1412661/smarthome/Code/Web service/pictures/files/manual/3.3.2014/21.32.25.jpg

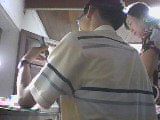
Code/Web service/pictures/files/manual/3.3.2014/21.32.25.jpg
