1412661/smarthome/Code/Web service/pictures/files/manual/4.3.2014/11.13.43.jpg

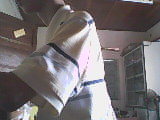
Code/Web service/pictures/files/manual/4.3.2014/11.13.43.jpg
