1412661/smarthome/Code/Web service/function/readme.txt

Thư mục lưu trữ các file php cung cấp các hàm (function) hỗ trợ cho việc vận hành website.
