1412661/smarthome/Code/Web service/class/phpmailer/readme.txt

Thư mục chứa PHP Class hỗ trợ việc gửi mail
