1412661/smarthome/Code/Web service/class/xtemplate/readme.txt

Thư mục chứa template engine của website
