1412661/smarthome/Code/Web service/pictures/files/auto/4.3.2014/13.14.15.jpg

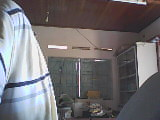
Code/Web service/pictures/files/auto/4.3.2014/13.14.15.jpg
