1412661/smarthome/Code/Web service/pictures/files/auto/7.3.2014/20.8.27.jpg

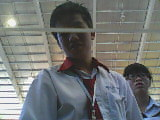
Code/Web service/pictures/files/auto/7.3.2014/20.8.27.jpg
