1412661/smarthome/Code/Web service/pictures/files/auto/7.3.2014/22.23.14.jpg

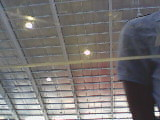
Code/Web service/pictures/files/auto/7.3.2014/22.23.14.jpg
