1412661/smarthome/Code/Web service/template/image/login.jpg

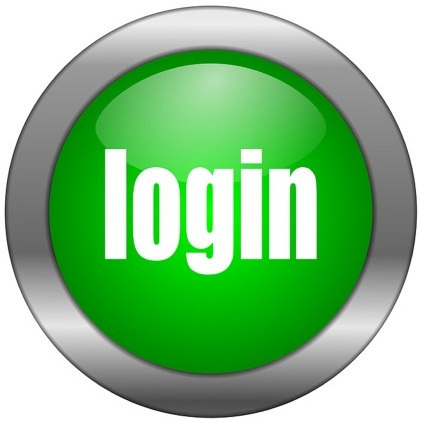
Code/Web service/template/image/login.jpg
