1412661/smarthome/NguyenQuocBao_PhuYen.jpg

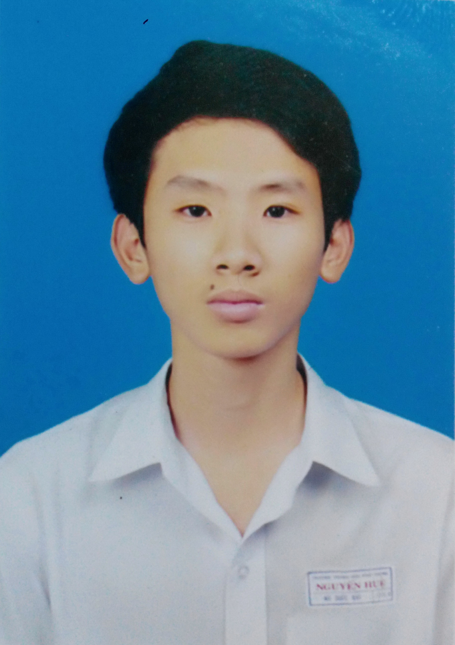
NguyenQuocBao_PhuYen.jpg
