1412661/smarthome/Pic/01012007207.jpg

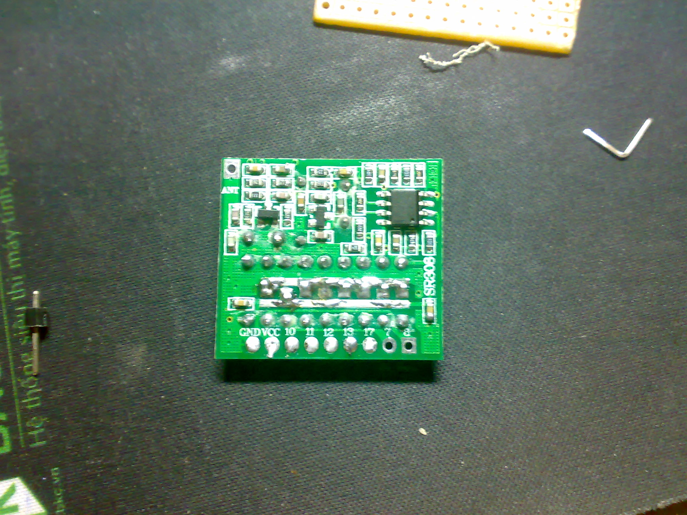
Pic/01012007207.jpg
