1412661/smarthome/Pic/01012007208.jpg

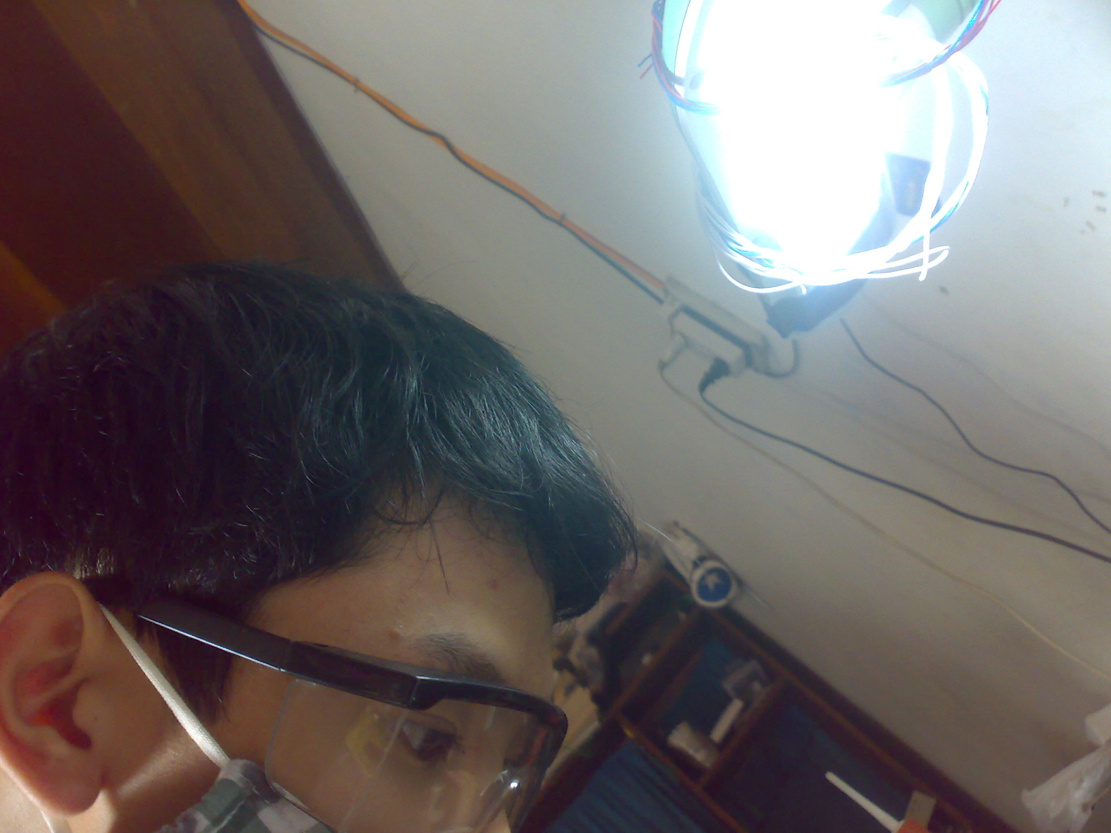
Pic/01012007208.jpg
