1412661/smarthome/Pic/01012007209.jpg

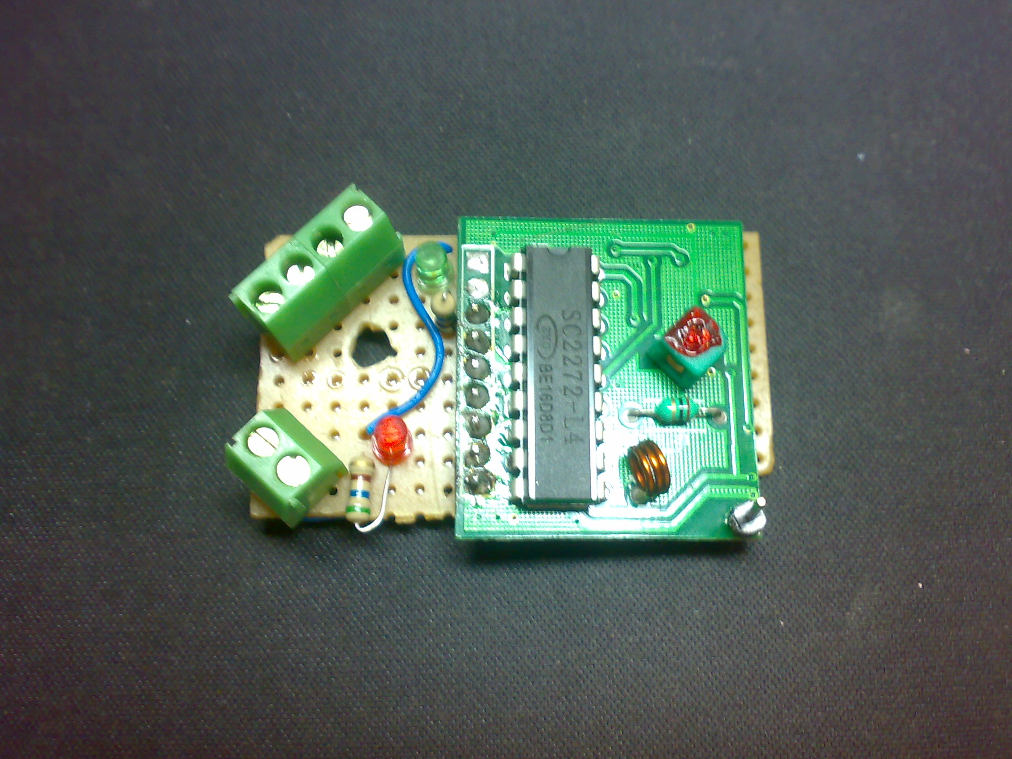
Pic/01012007209.jpg
