1412661/smarthome/Pic/01012007212.jpg

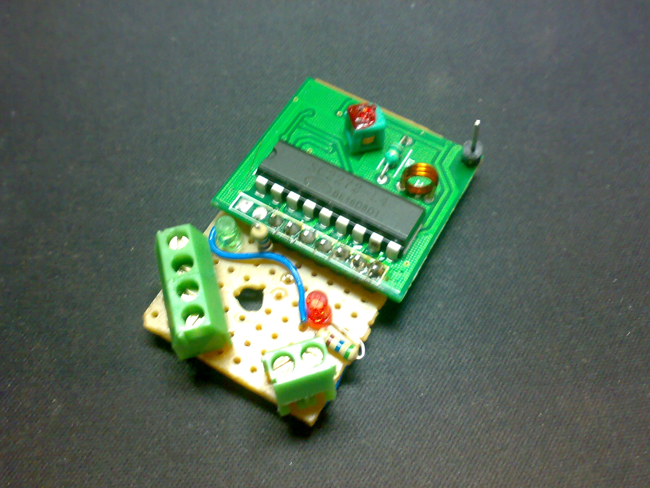
Pic/01012007212.jpg
