1412661/smarthome/Pic/01012007218.jpg

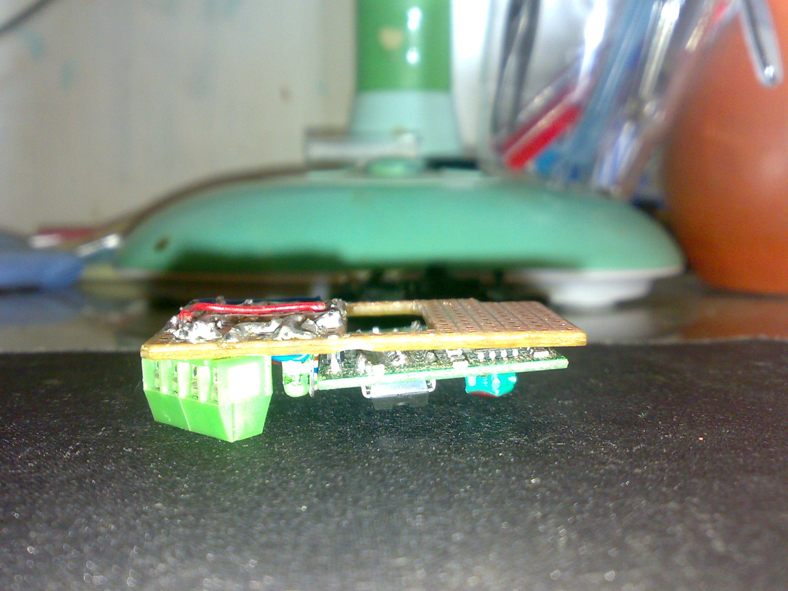
Pic/01012007218.jpg
