1412661/smarthome/Pic/01012014253.jpg

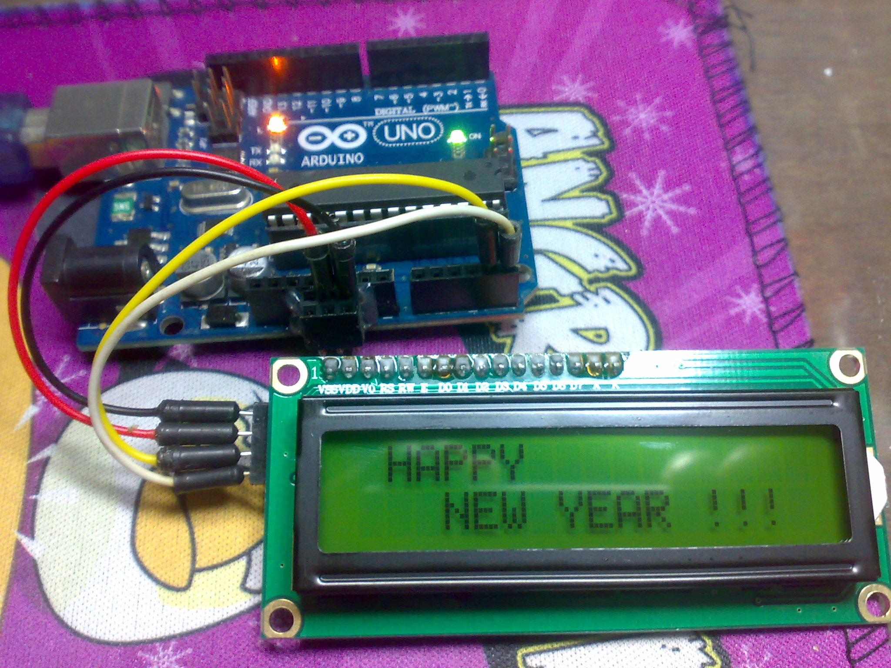
Pic/01012014253.jpg
