1412661/smarthome/Pic/02012014254.jpg

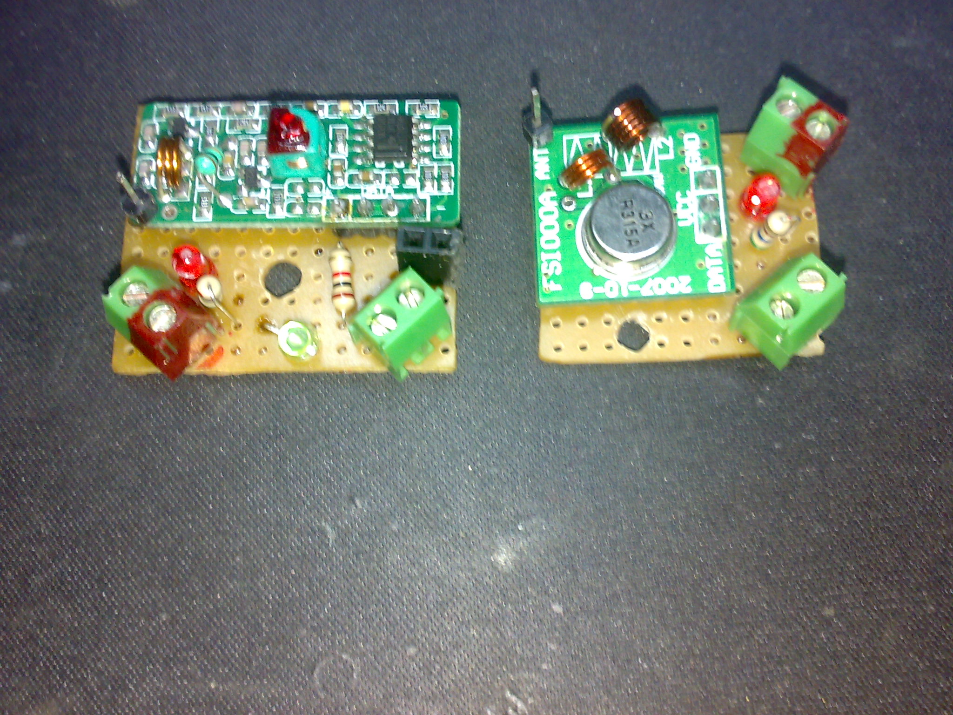
Pic/02012014254.jpg
