1412661/smarthome/Pic/02012014255.jpg

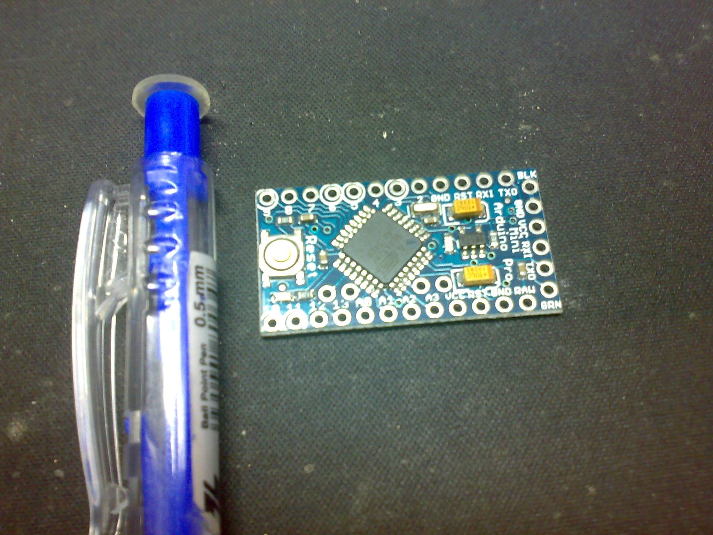
Pic/02012014255.jpg
