1412661/smarthome/Pic/04012014260.jpg

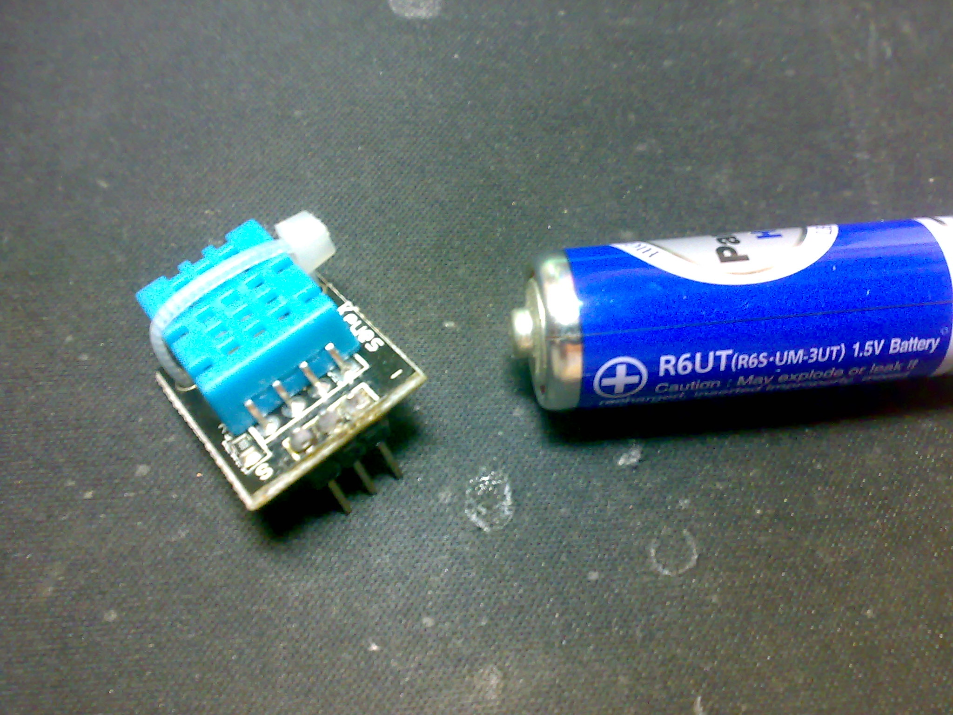
Pic/04012014260.jpg
