1412661/smarthome/Pic/04012014261.jpg

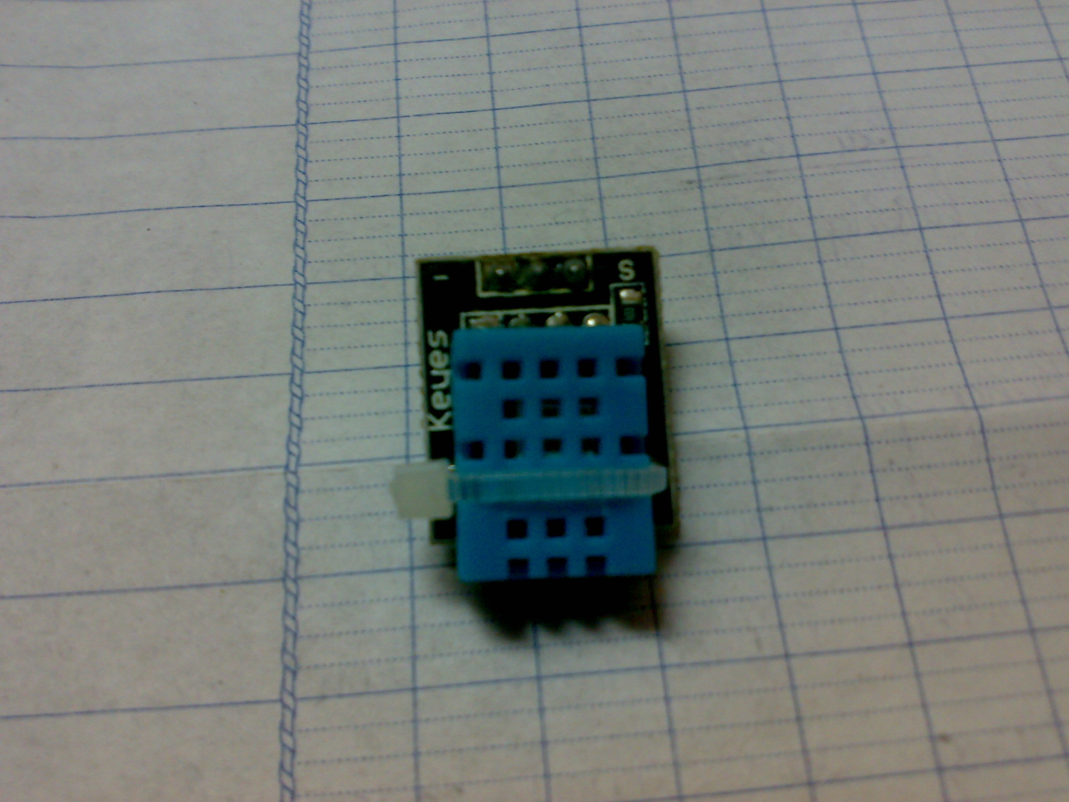
Pic/04012014261.jpg
