1412661/smarthome/Pic/04012014263.jpg

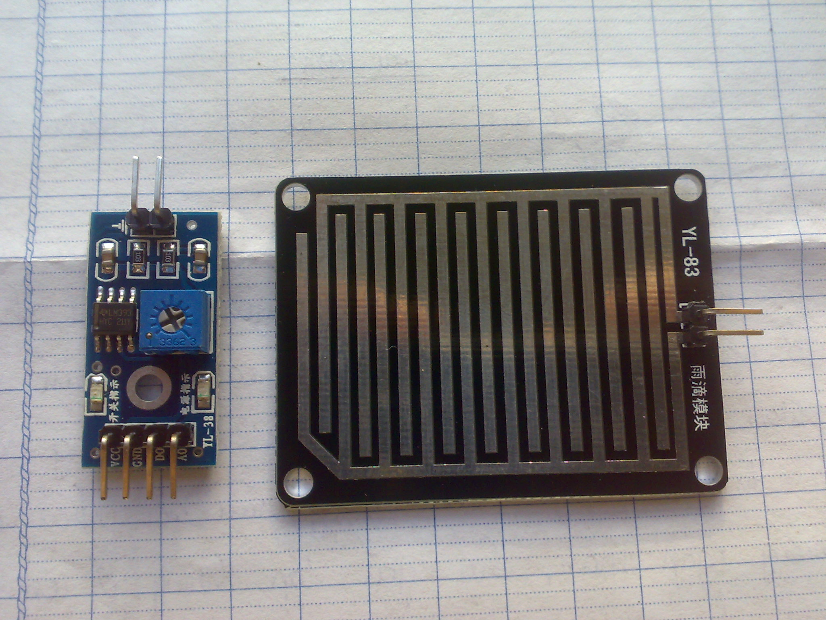
Pic/04012014263.jpg
