1412661/smarthome/Pic/04012014264.jpg

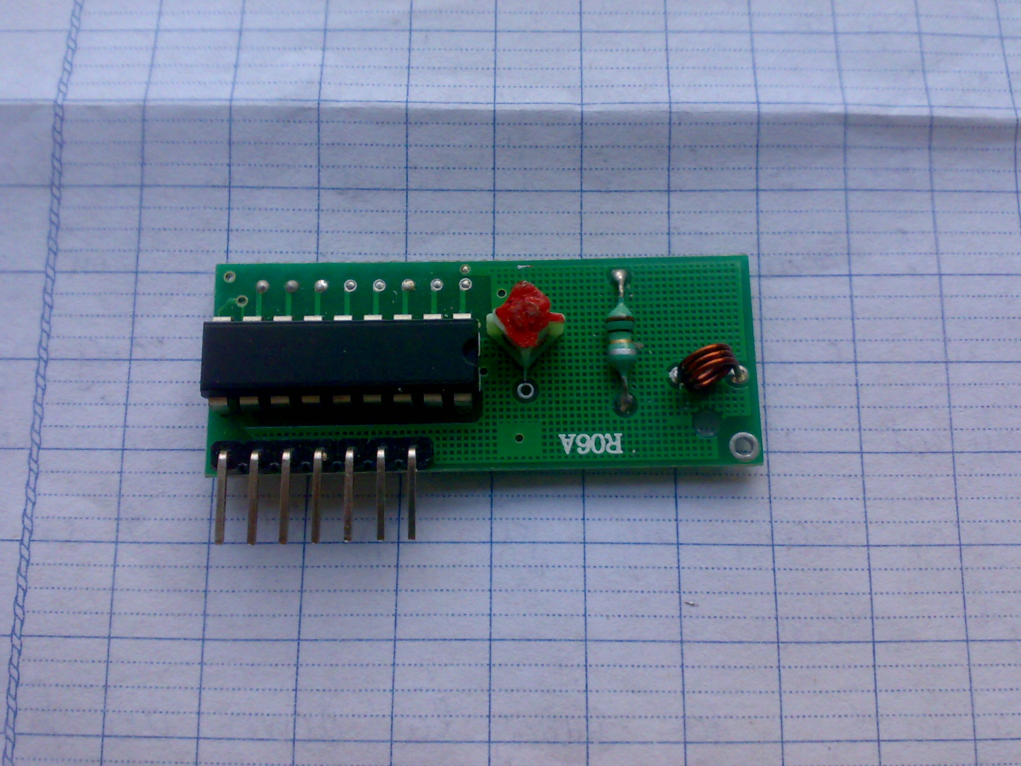
Pic/04012014264.jpg
