1412661/smarthome/Pic/04012014265.jpg

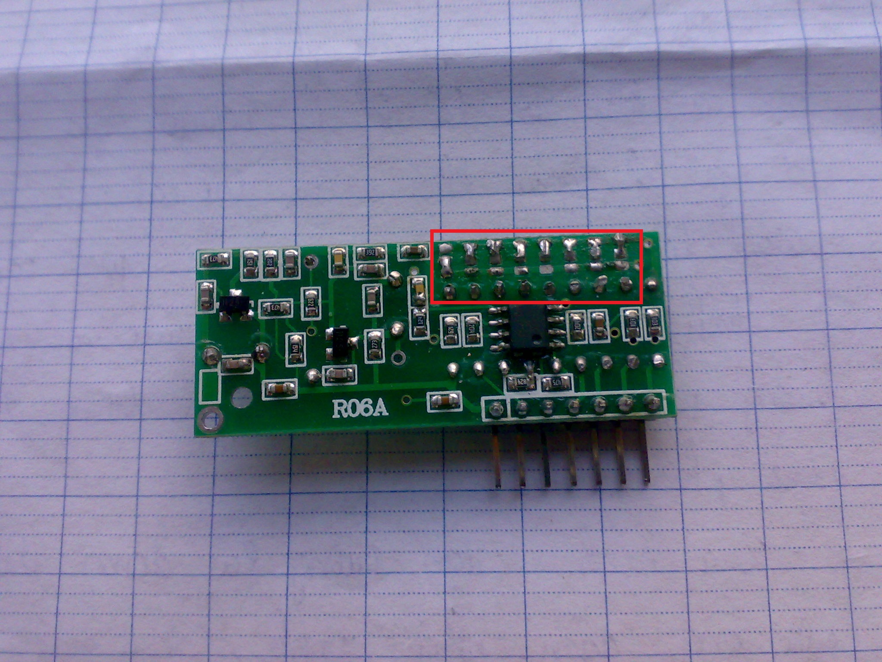
Pic/04012014265.jpg
