1412661/smarthome/Pic/04012014267.jpg

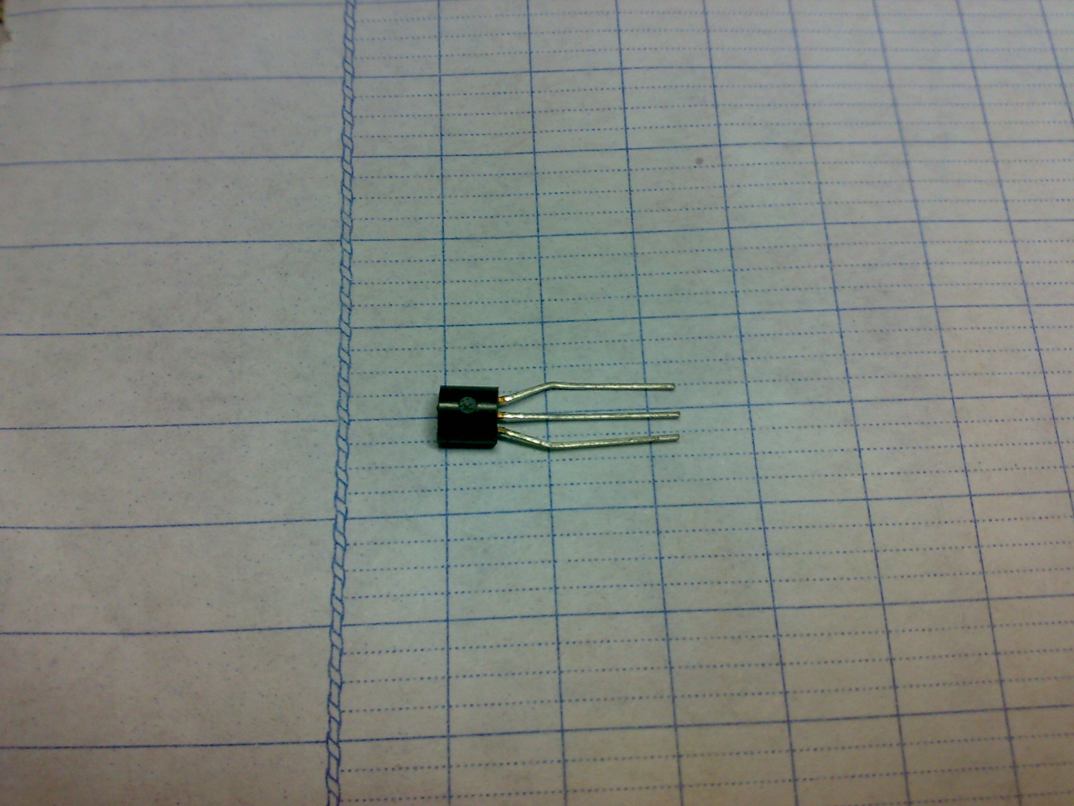
Pic/04012014267.jpg
