1412661/smarthome/Pic/05012014268.jpg

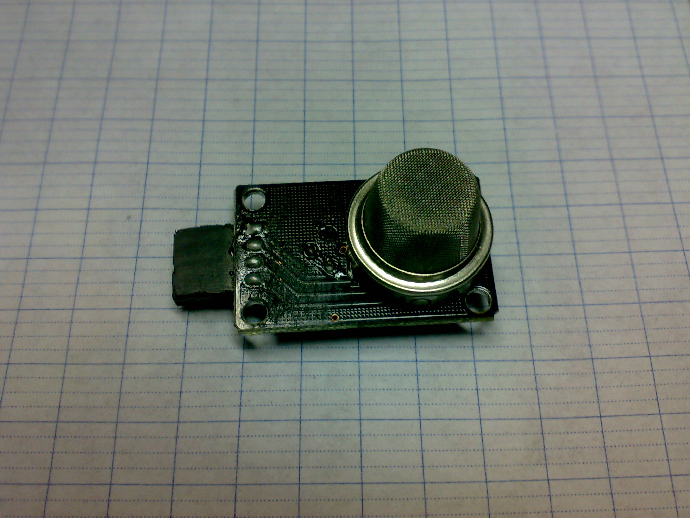
Pic/05012014268.jpg
