1412661/smarthome/Pic/05012014269.jpg

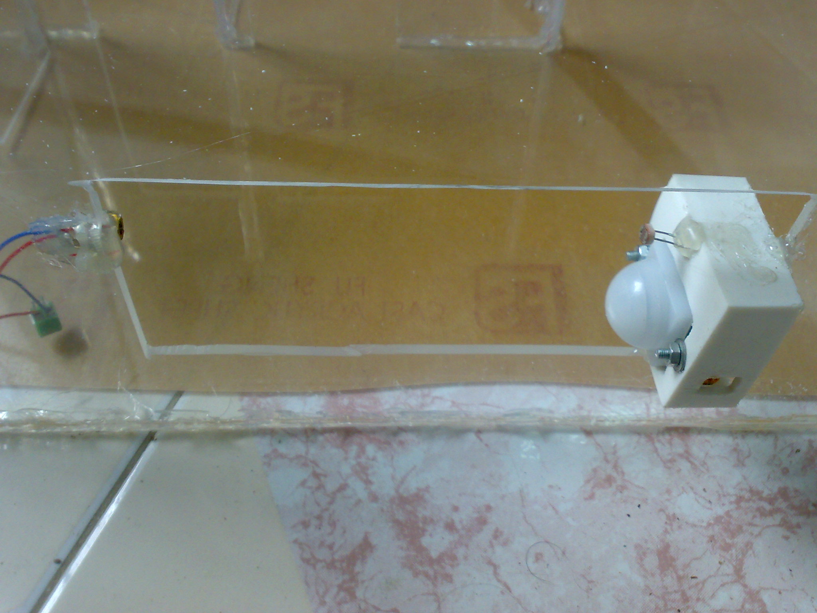
Pic/05012014269.jpg
