1412661/smarthome/Pic/05012014272.jpg

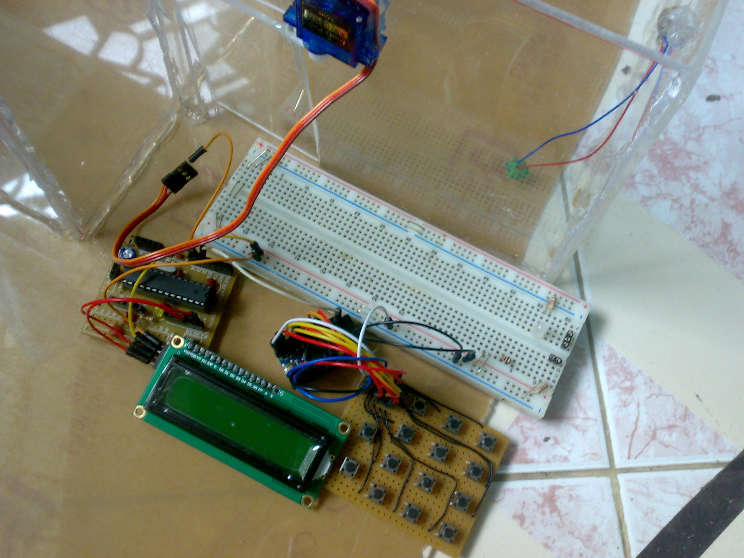
Pic/05012014272.jpg
