1412661/smarthome/Pic/07012014273.jpg

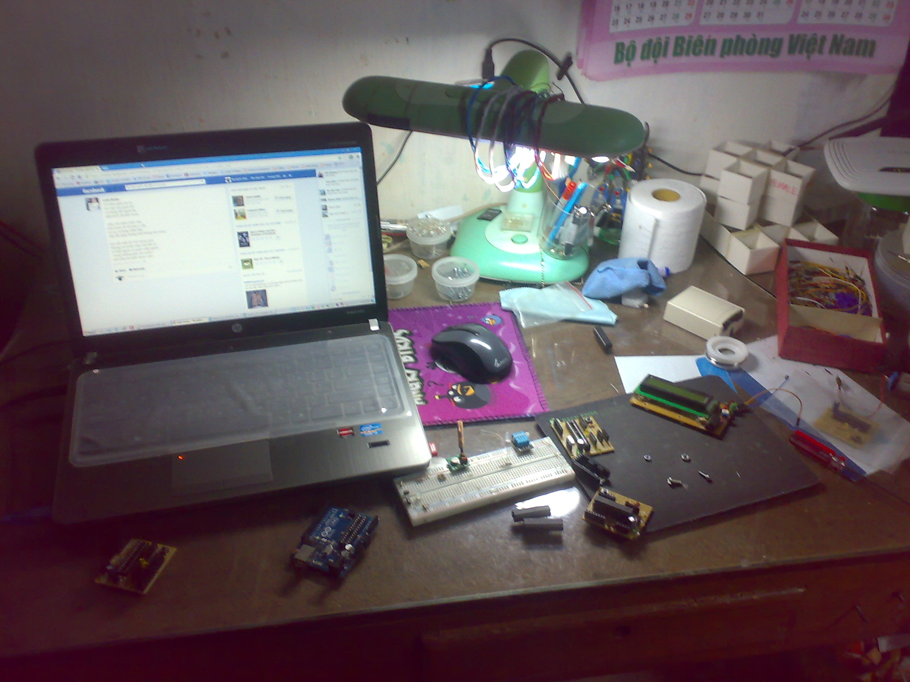
Pic/07012014273.jpg
