1412661/smarthome/Pic/07012014274.jpg

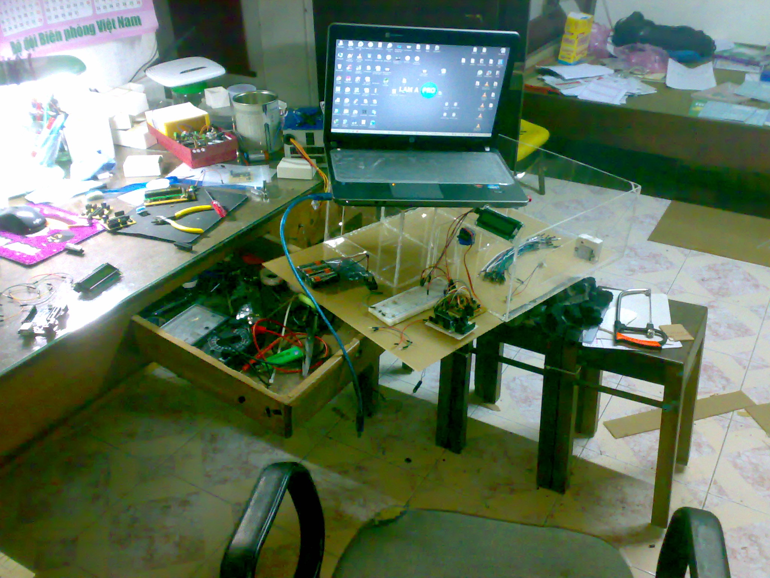
Pic/07012014274.jpg
