1412661/smarthome/Pic/08012014275.jpg

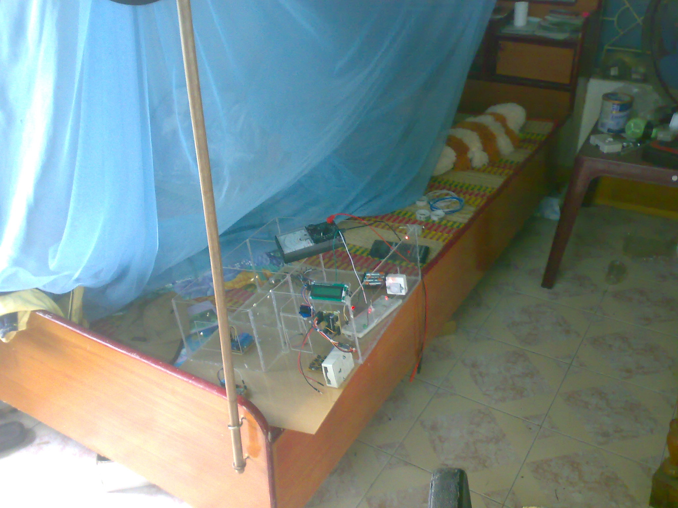
Pic/08012014275.jpg
