1412661/smarthome/Pic/08012014276.jpg

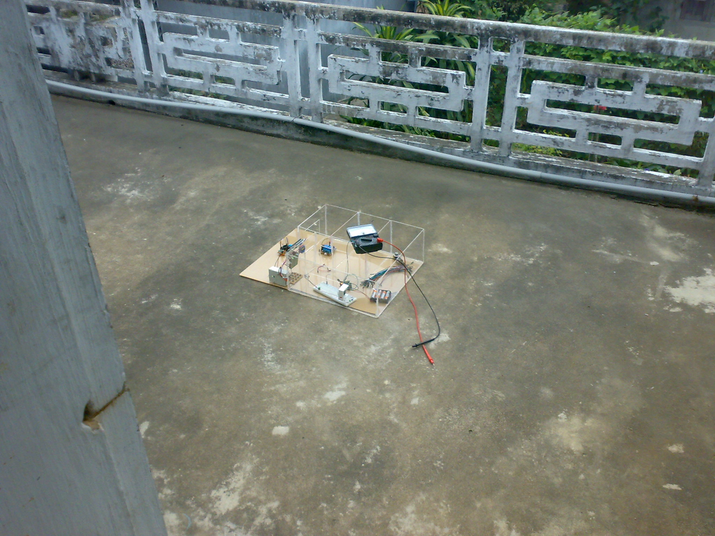
Pic/08012014276.jpg
