1412661/smarthome/Pic/09012014278.jpg

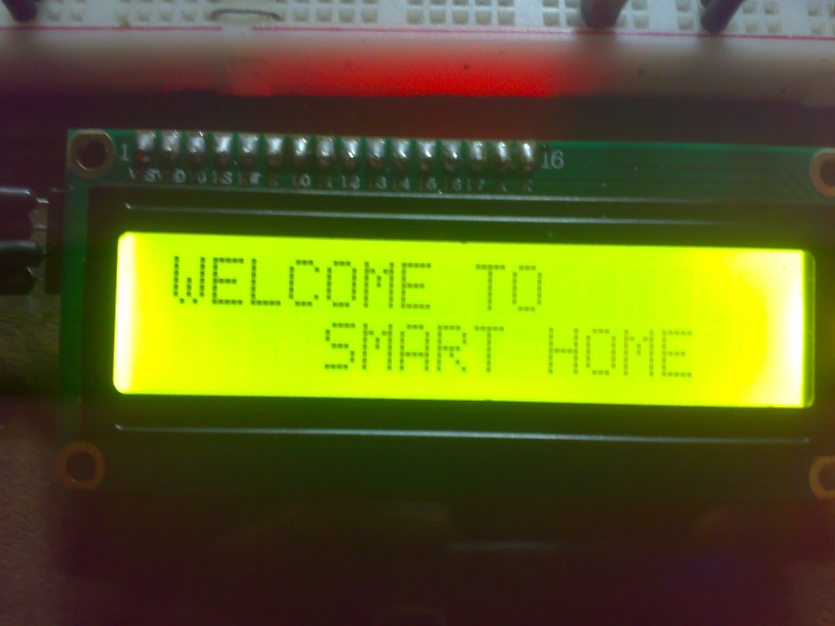
Pic/09012014278.jpg
