1412661/smarthome/Pic/09012014279.jpg

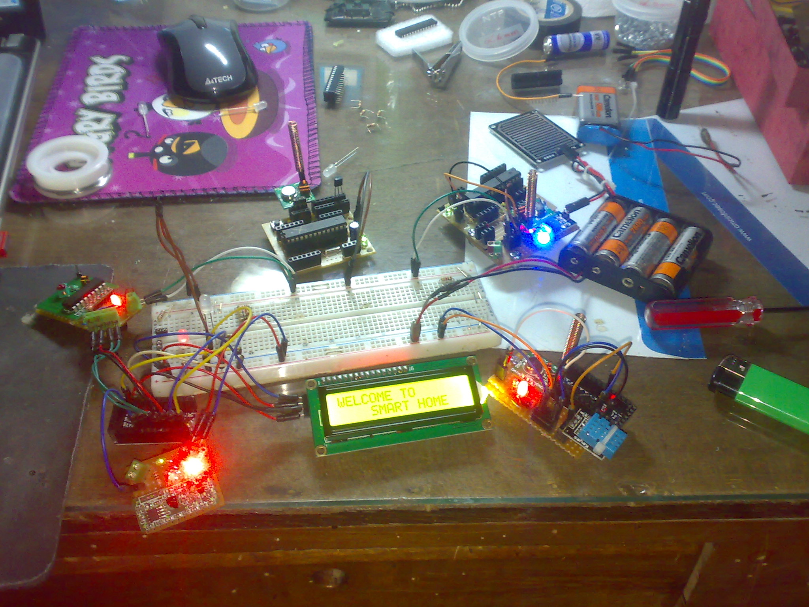
Pic/09012014279.jpg
