1412661/smarthome/Pic/09012014280.jpg

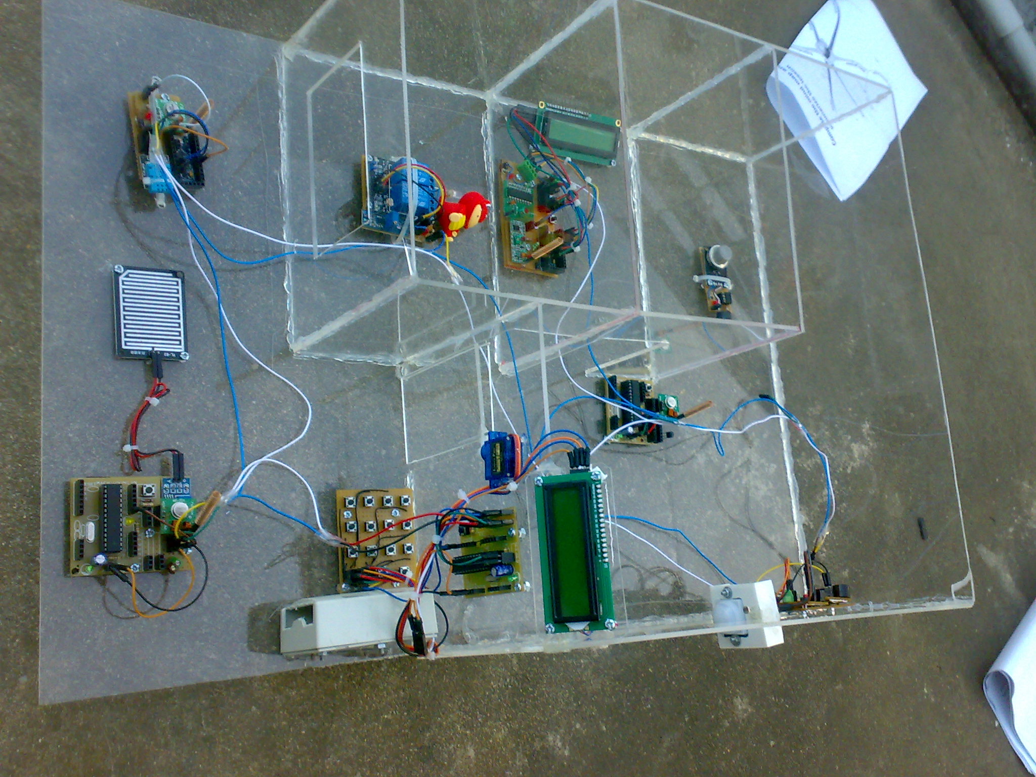
Pic/09012014280.jpg
