1412661/smarthome/Pic/12012014281.jpg

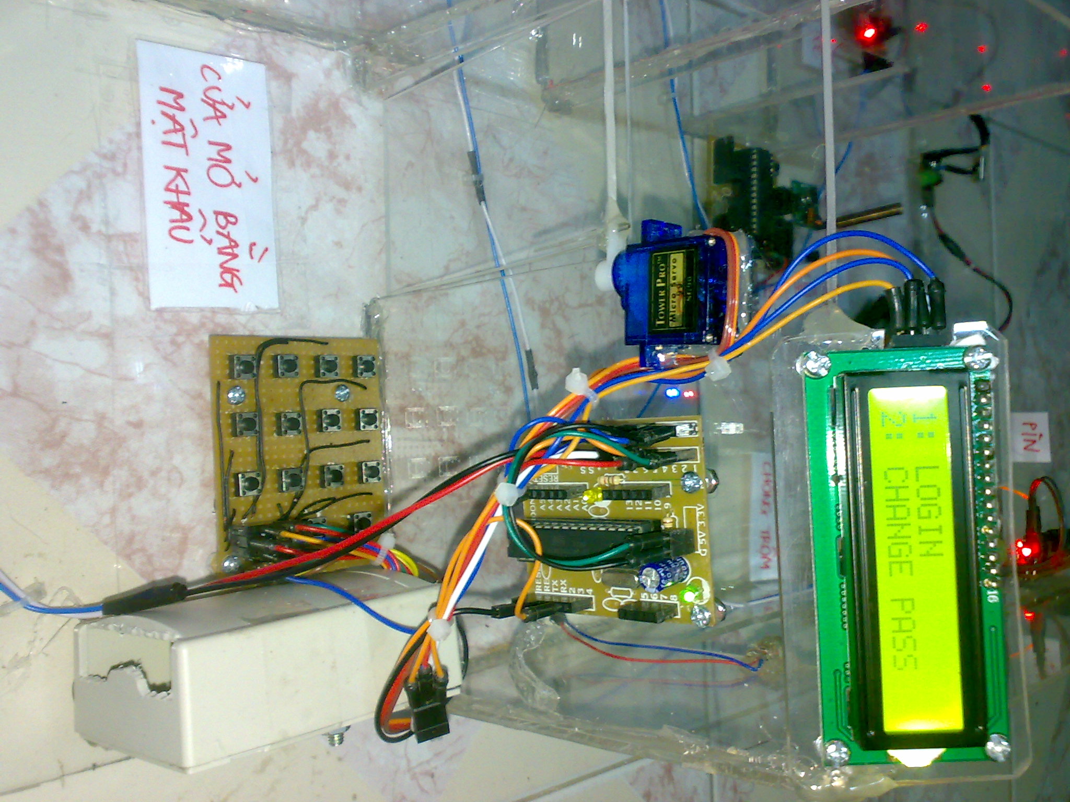
Pic/12012014281.jpg
