1412661/smarthome/Pic/12012014283.jpg

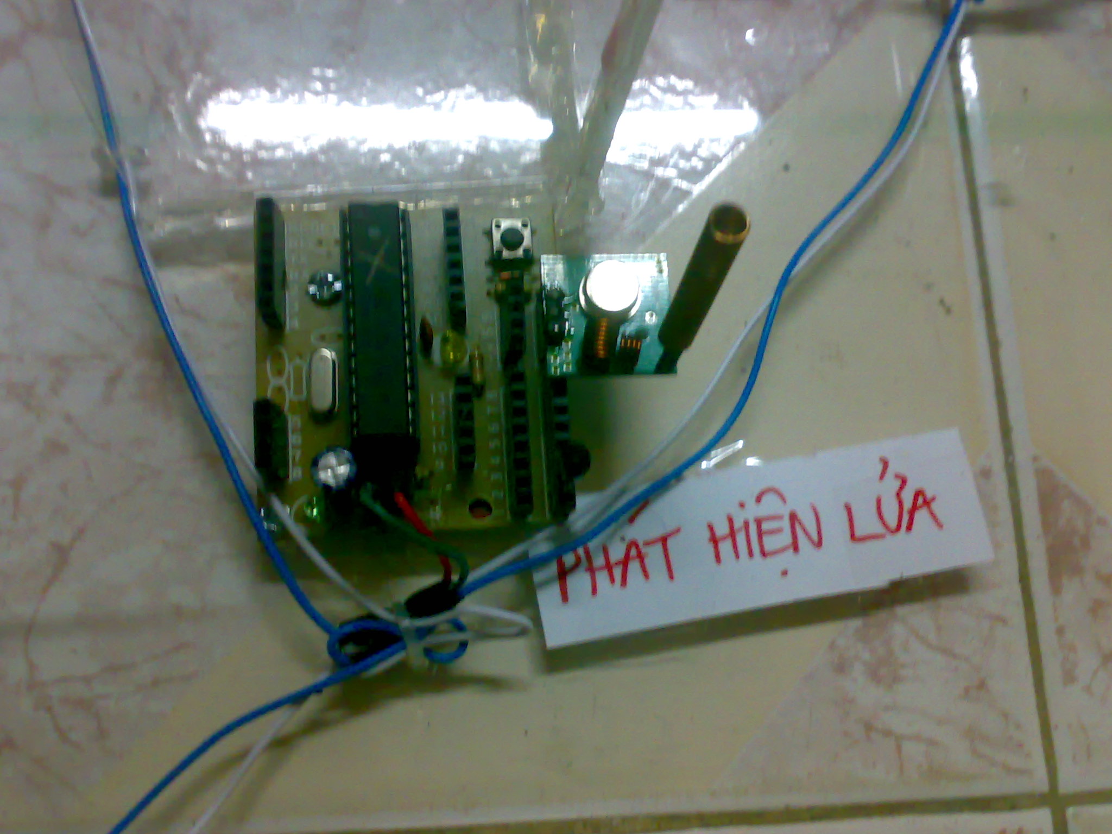
Pic/12012014283.jpg
