1412661/smarthome/Pic/12012014285.jpg

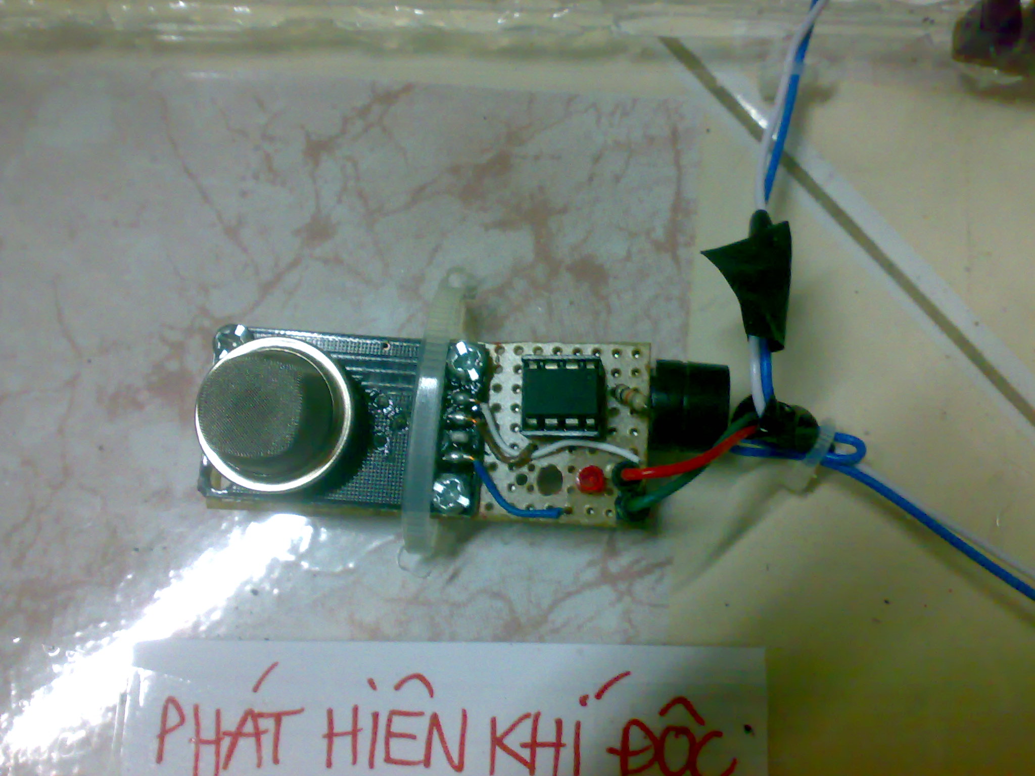
Pic/12012014285.jpg
