1412661/smarthome/Pic/12012014286.jpg

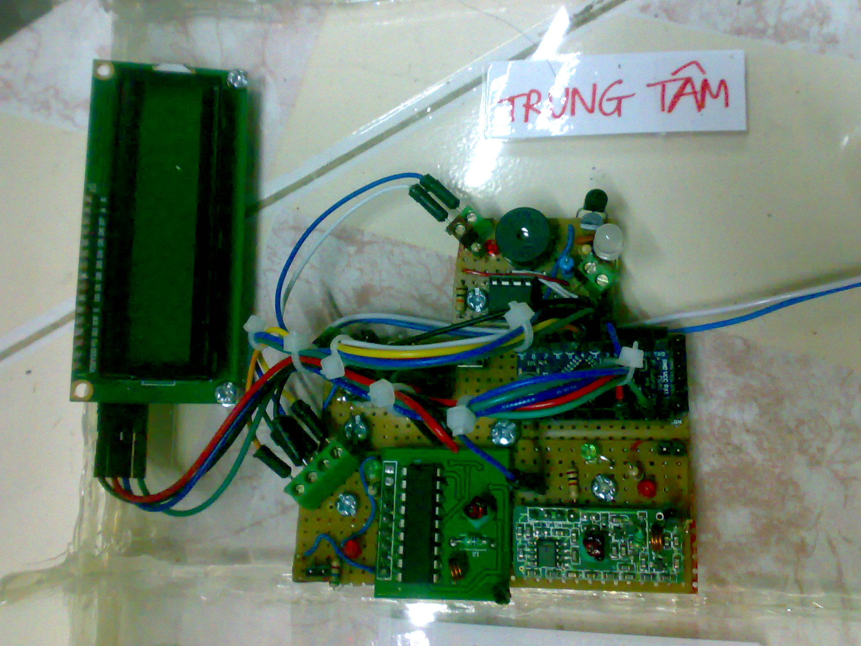
Pic/12012014286.jpg
