1412661/smarthome/Pic/12012014287.jpg

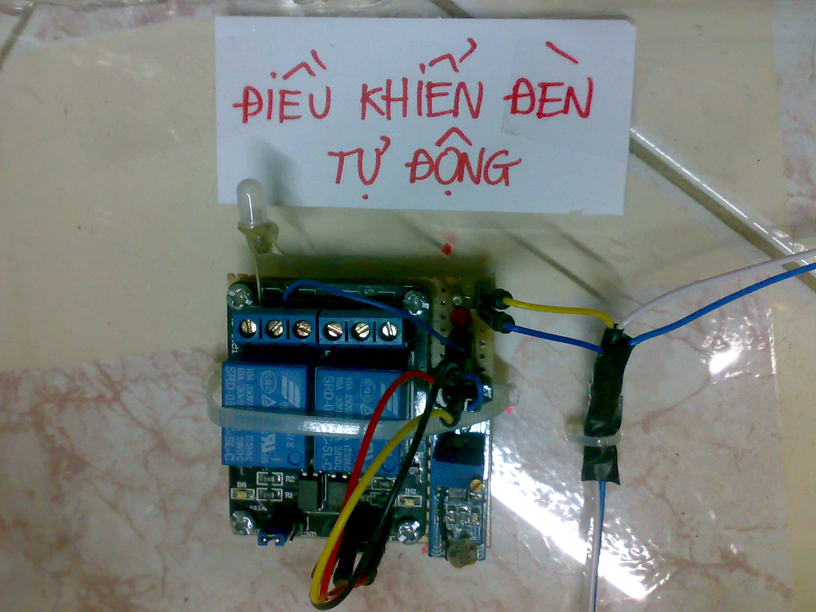
Pic/12012014287.jpg
