1412661/smarthome/Pic/12012014288.jpg

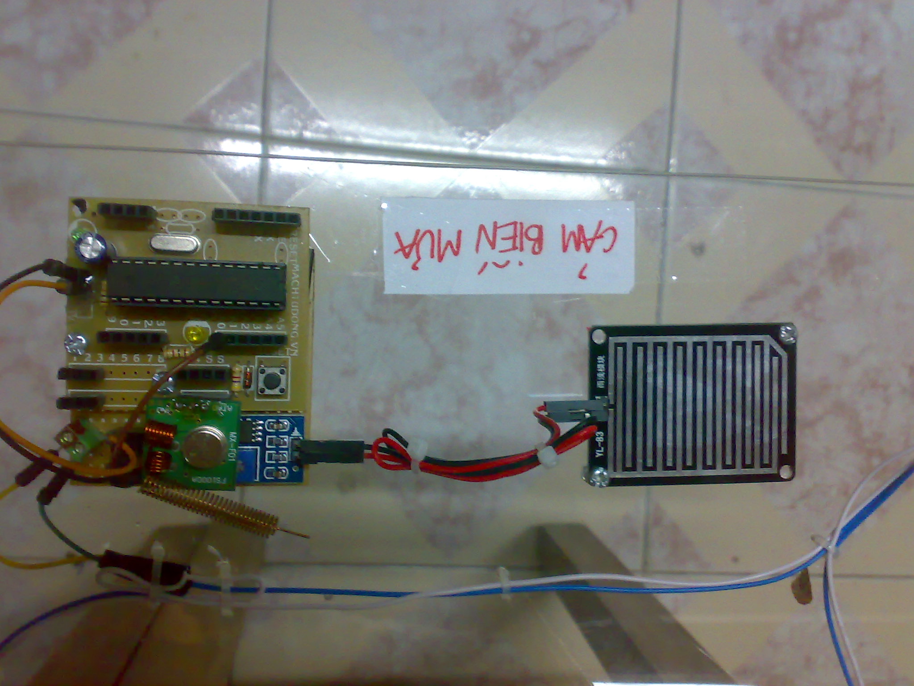
Pic/12012014288.jpg
