1412661/smarthome/Pic/12012014290.jpg

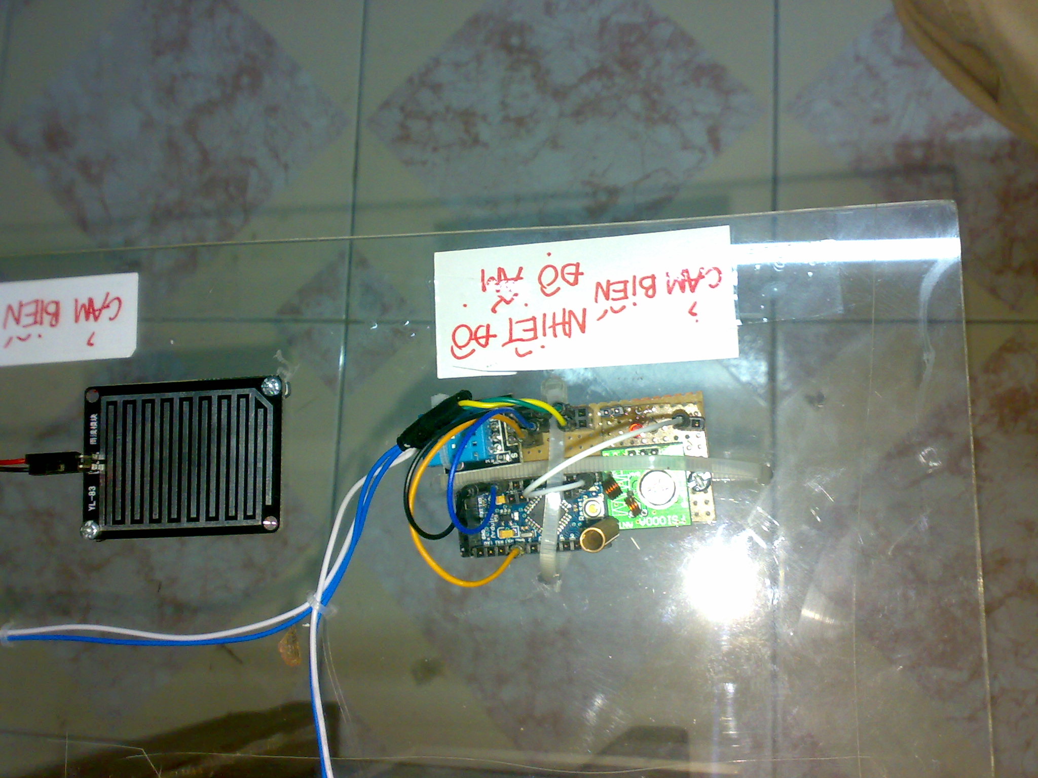
Pic/12012014290.jpg
