1412661/smarthome/Pic/12012014291.jpg

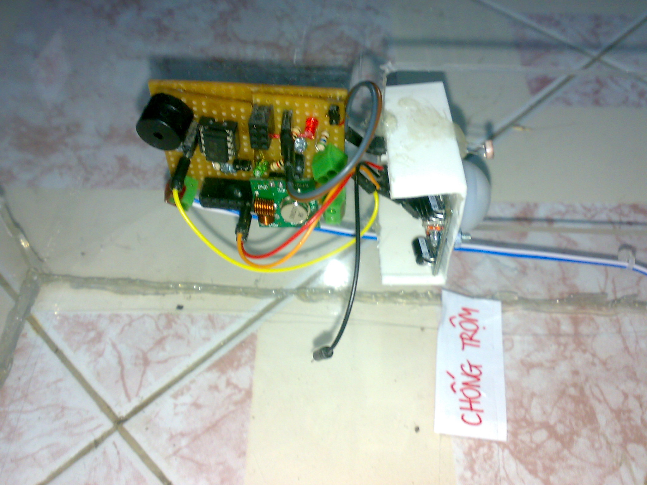
Pic/12012014291.jpg
