1412661/smarthome/Pic/12012014292.jpg

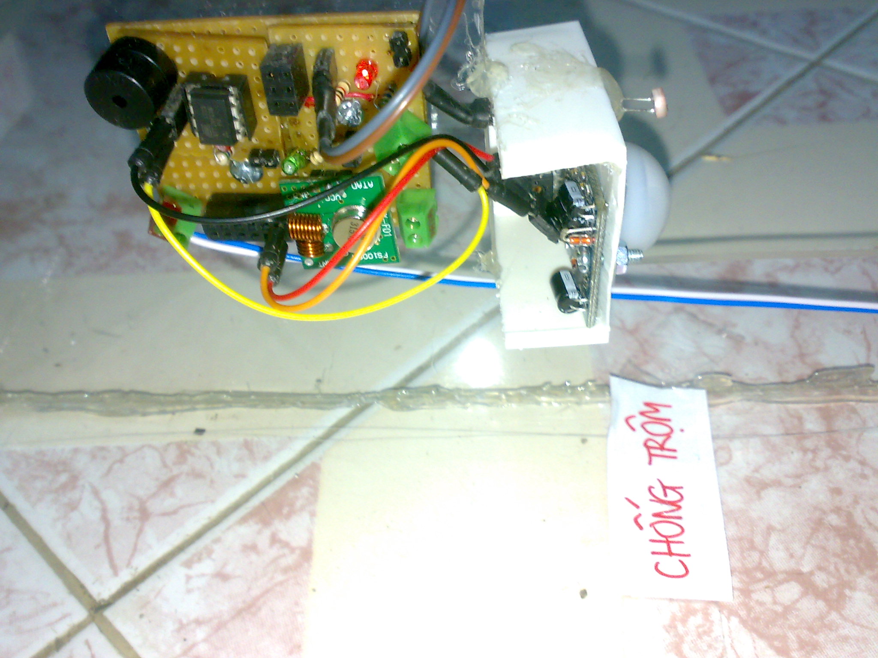
Pic/12012014292.jpg
