1412661/smarthome/Pic/17122013224.jpg

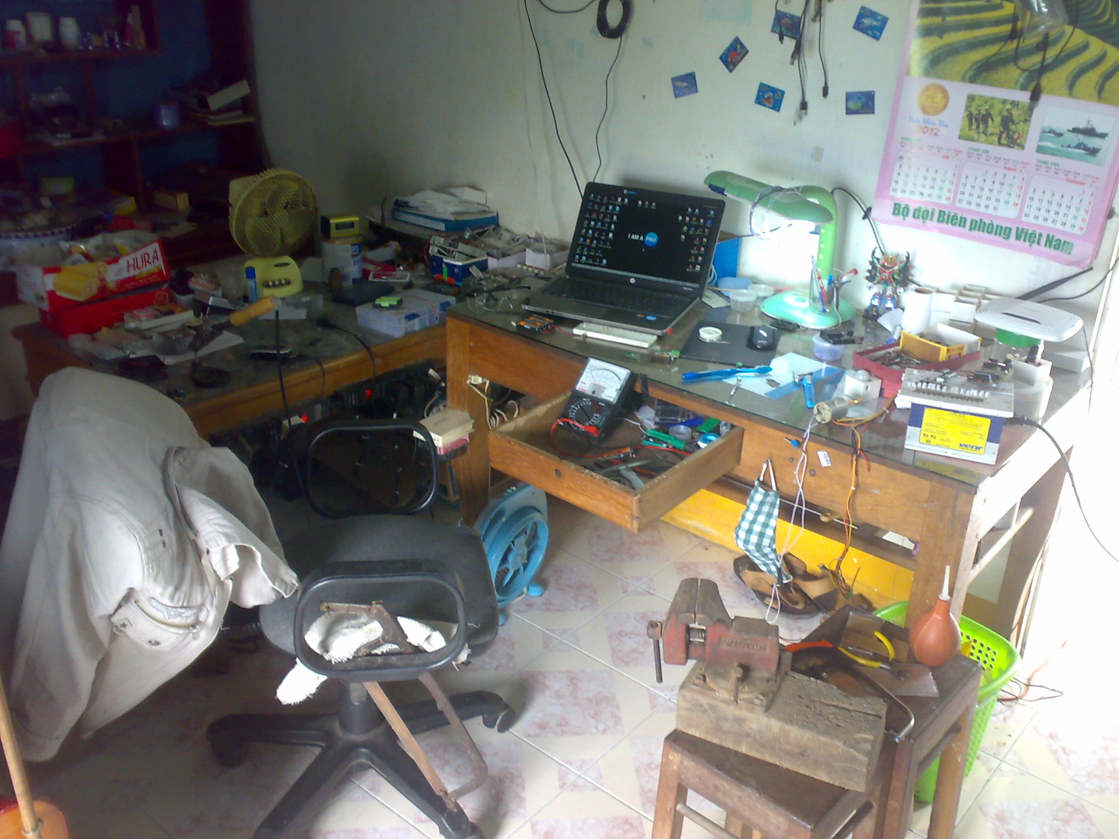
Pic/17122013224.jpg
