1412661/smarthome/Pic/29122013235.jpg

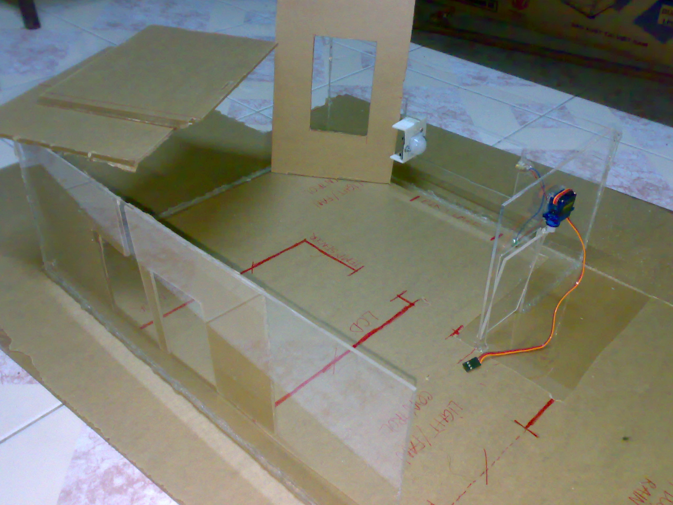
Pic/29122013235.jpg
