1412661/smarthome/Pic/29122013236.jpg

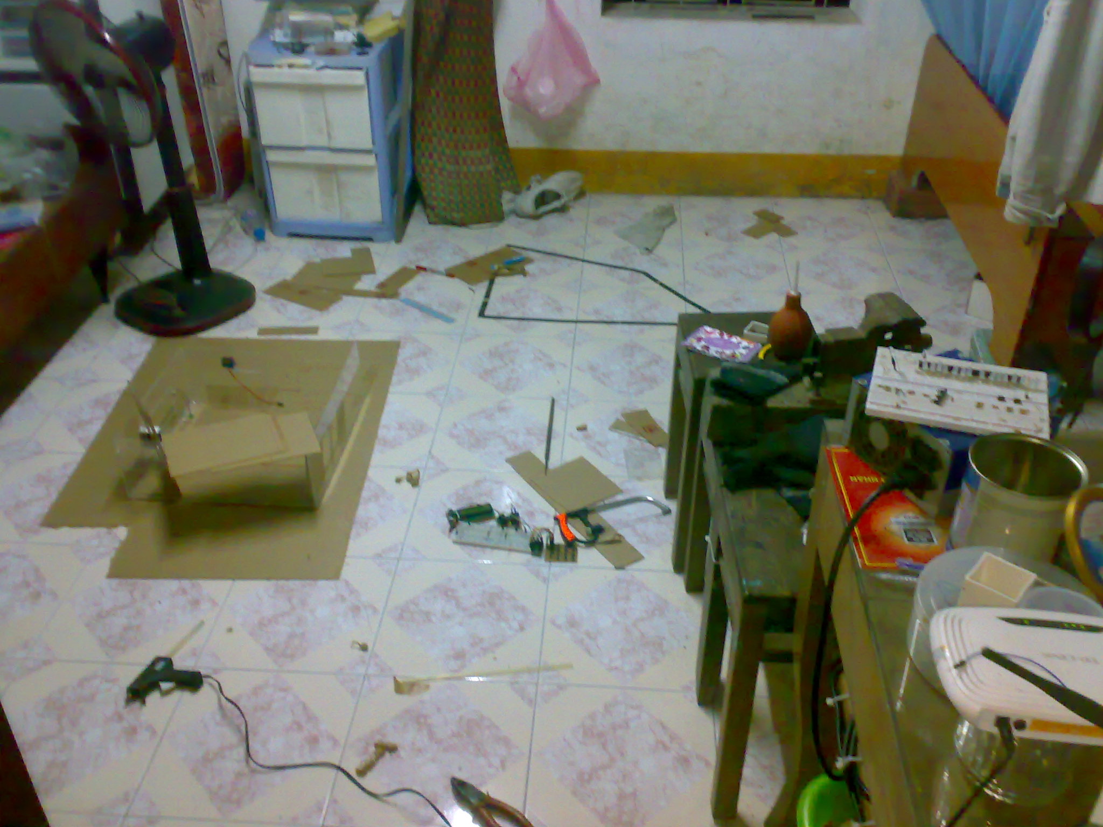
Pic/29122013236.jpg
