1412661/smarthome/Pic/29122013239.jpg

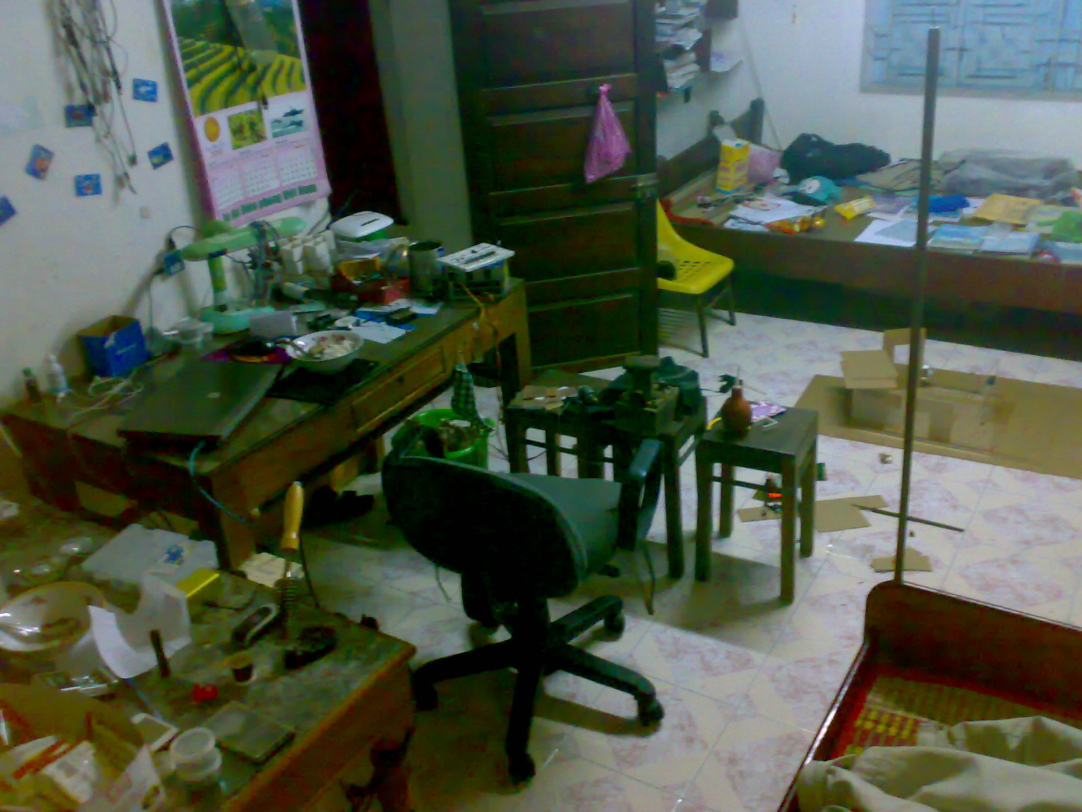
Pic/29122013239.jpg
