1412661/smarthome/Pic/29122013240.jpg

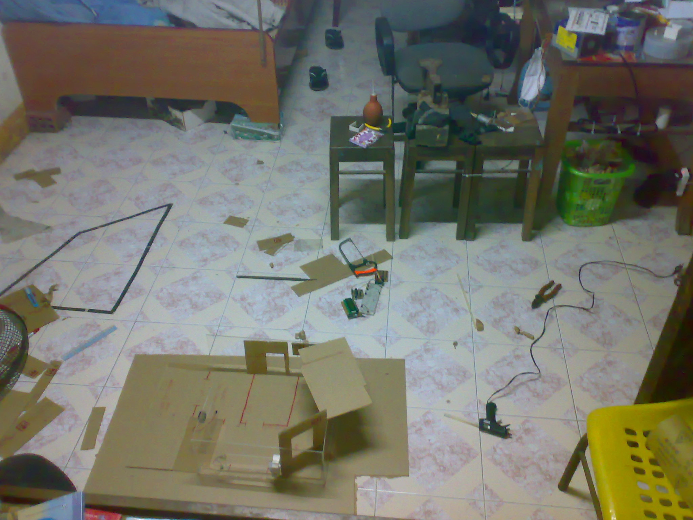
Pic/29122013240.jpg
