1412661/smarthome/Pic/30112013203.jpg

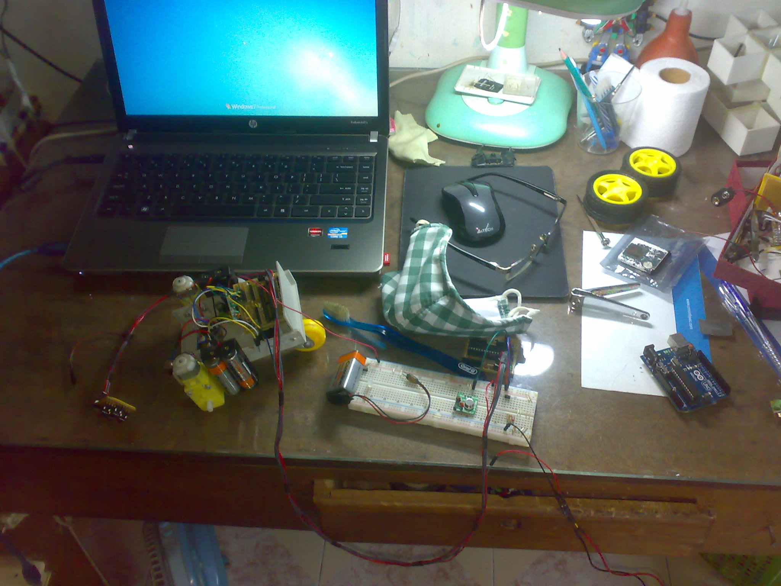
Pic/30112013203.jpg
