1412661/smarthome/Pic/30112013204.jpg

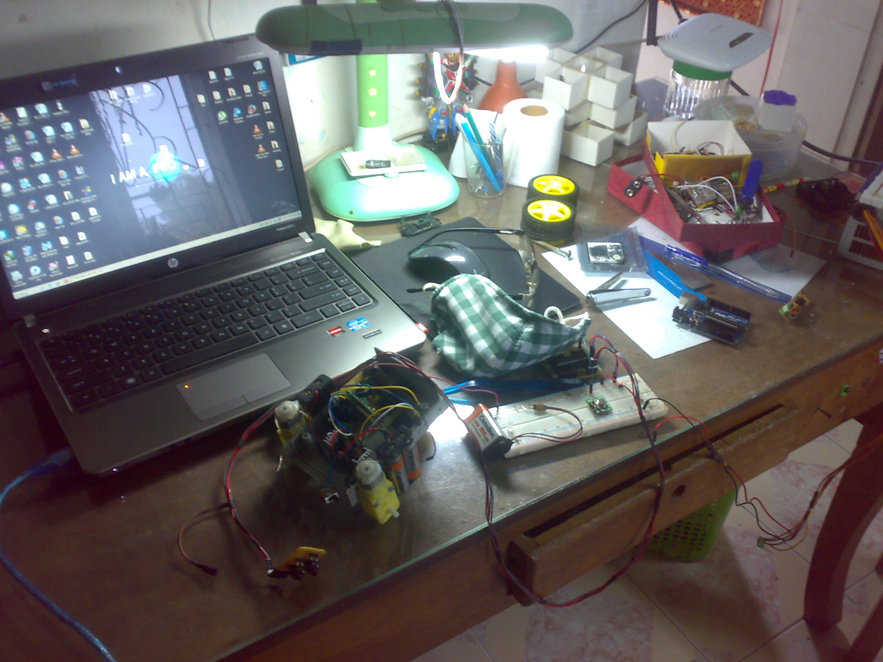
Pic/30112013204.jpg
