1412661/smarthome/Pic/31122013242.jpg

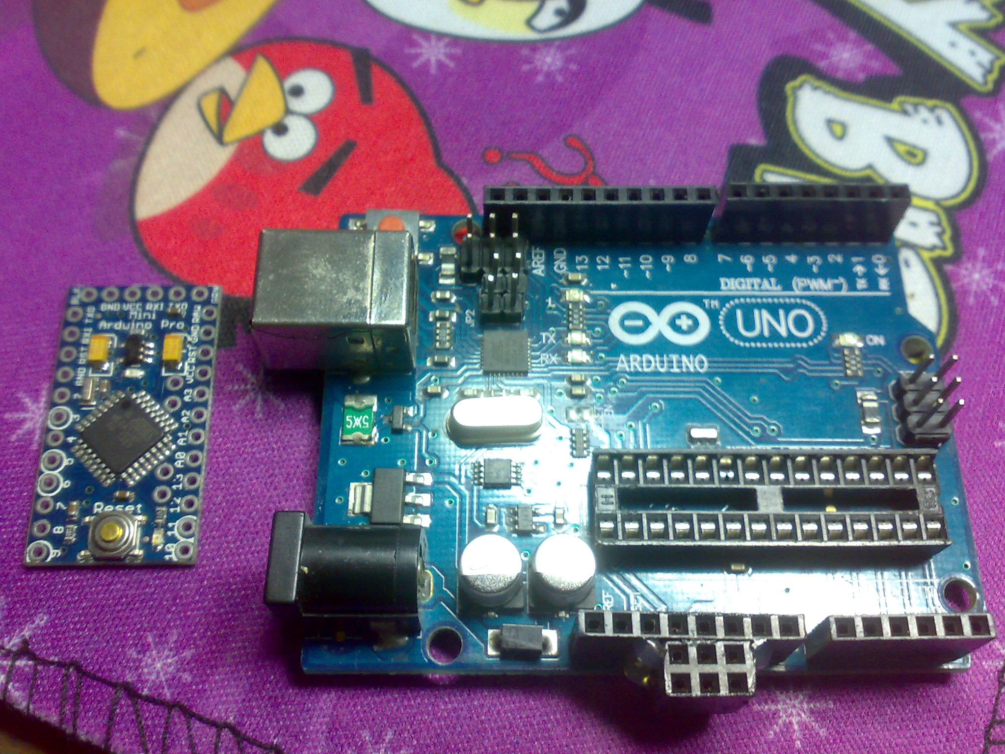
Pic/31122013242.jpg
