1412661/smarthome/Pic/31122013244.jpg

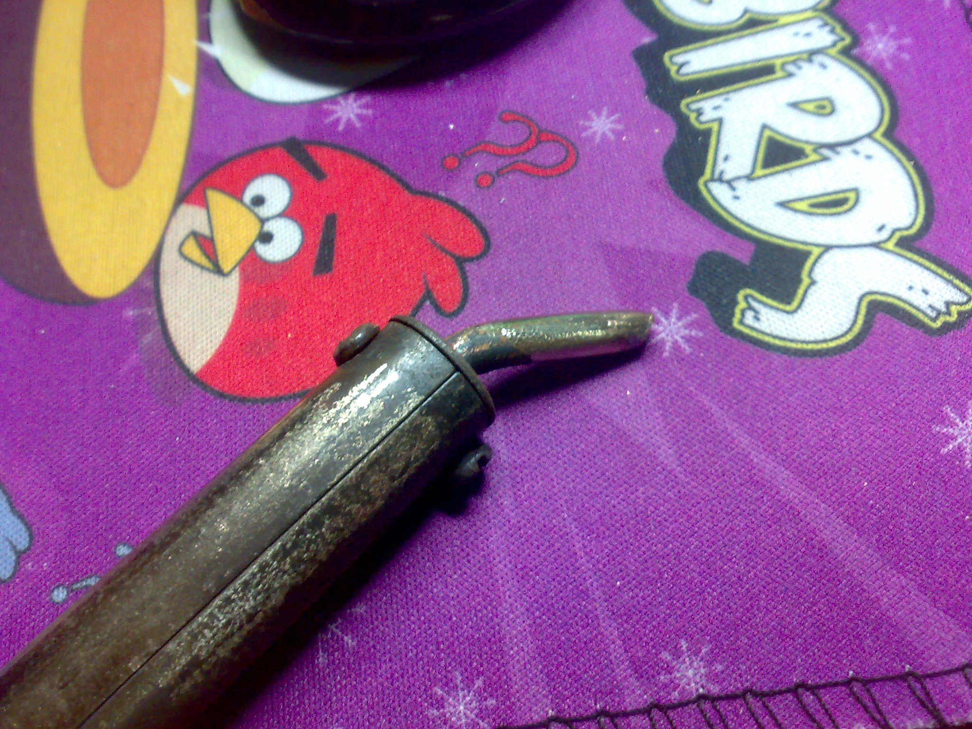
Pic/31122013244.jpg
