1412661/smarthome/Pic/31122013246.jpg

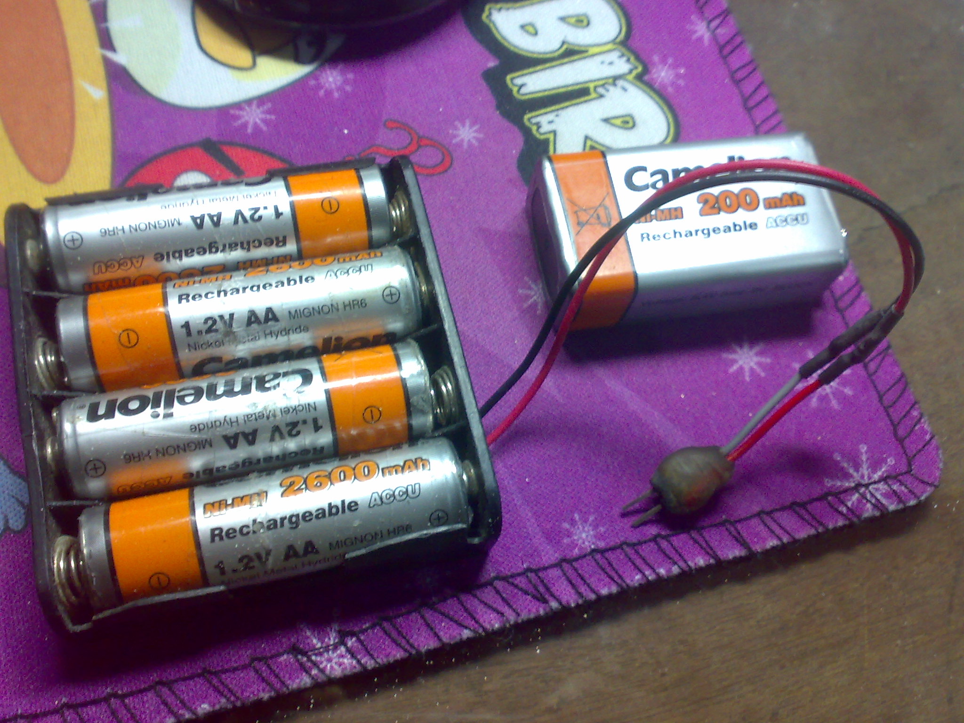
Pic/31122013246.jpg
