1412661/smarthome/Pic/31122013247.jpg

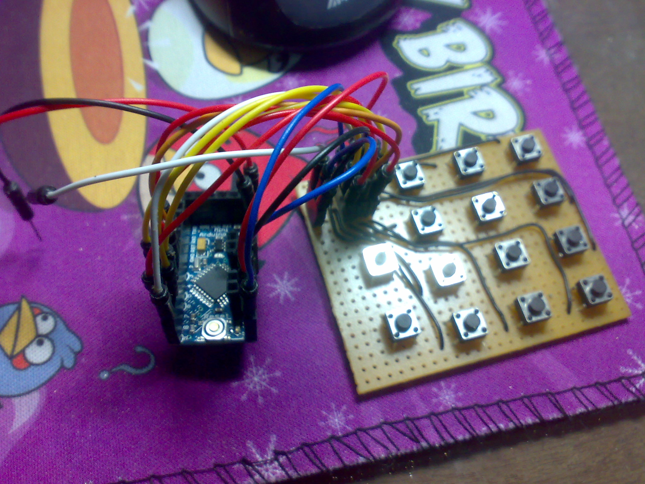
Pic/31122013247.jpg
