1412661/smarthome/Pic/31122013249.jpg

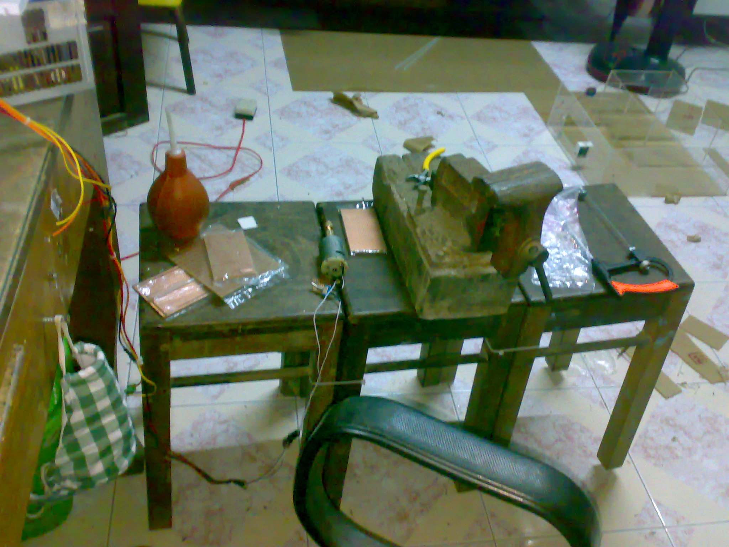
Pic/31122013249.jpg
