1412661/smarthome/Pic/31122013251.jpg

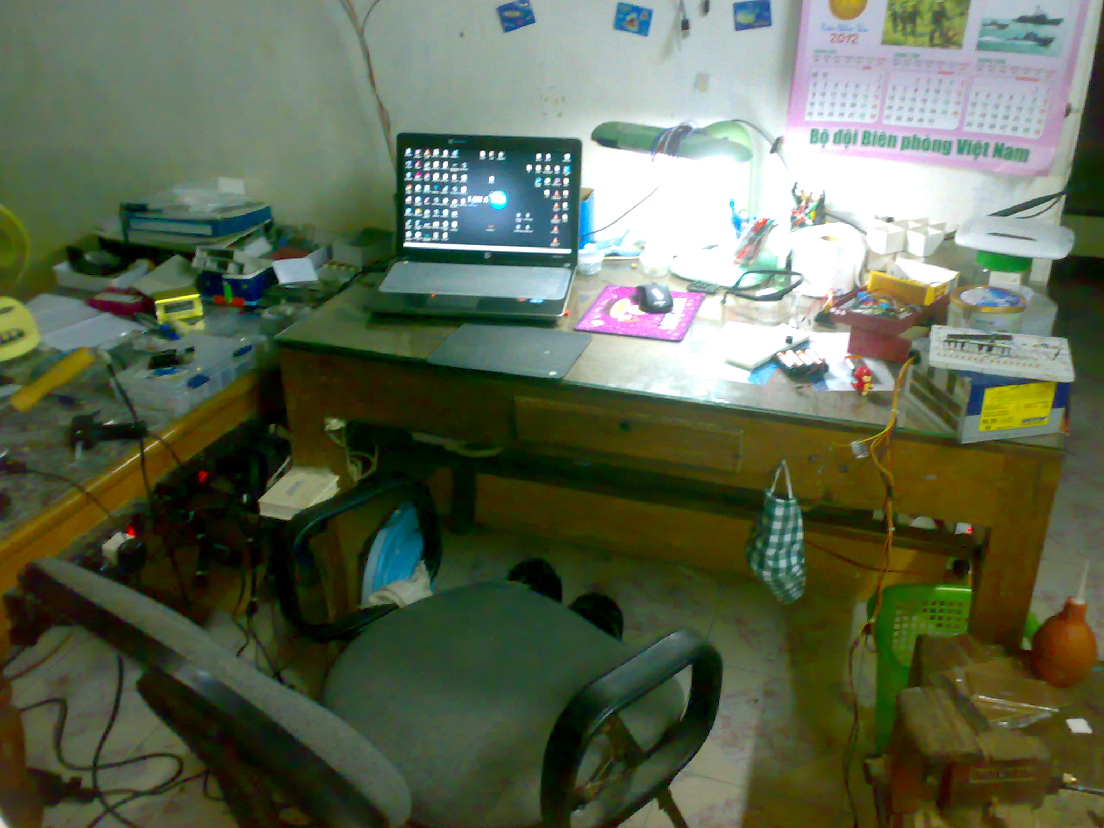
Pic/31122013251.jpg
