1412661/smarthome/poster.png

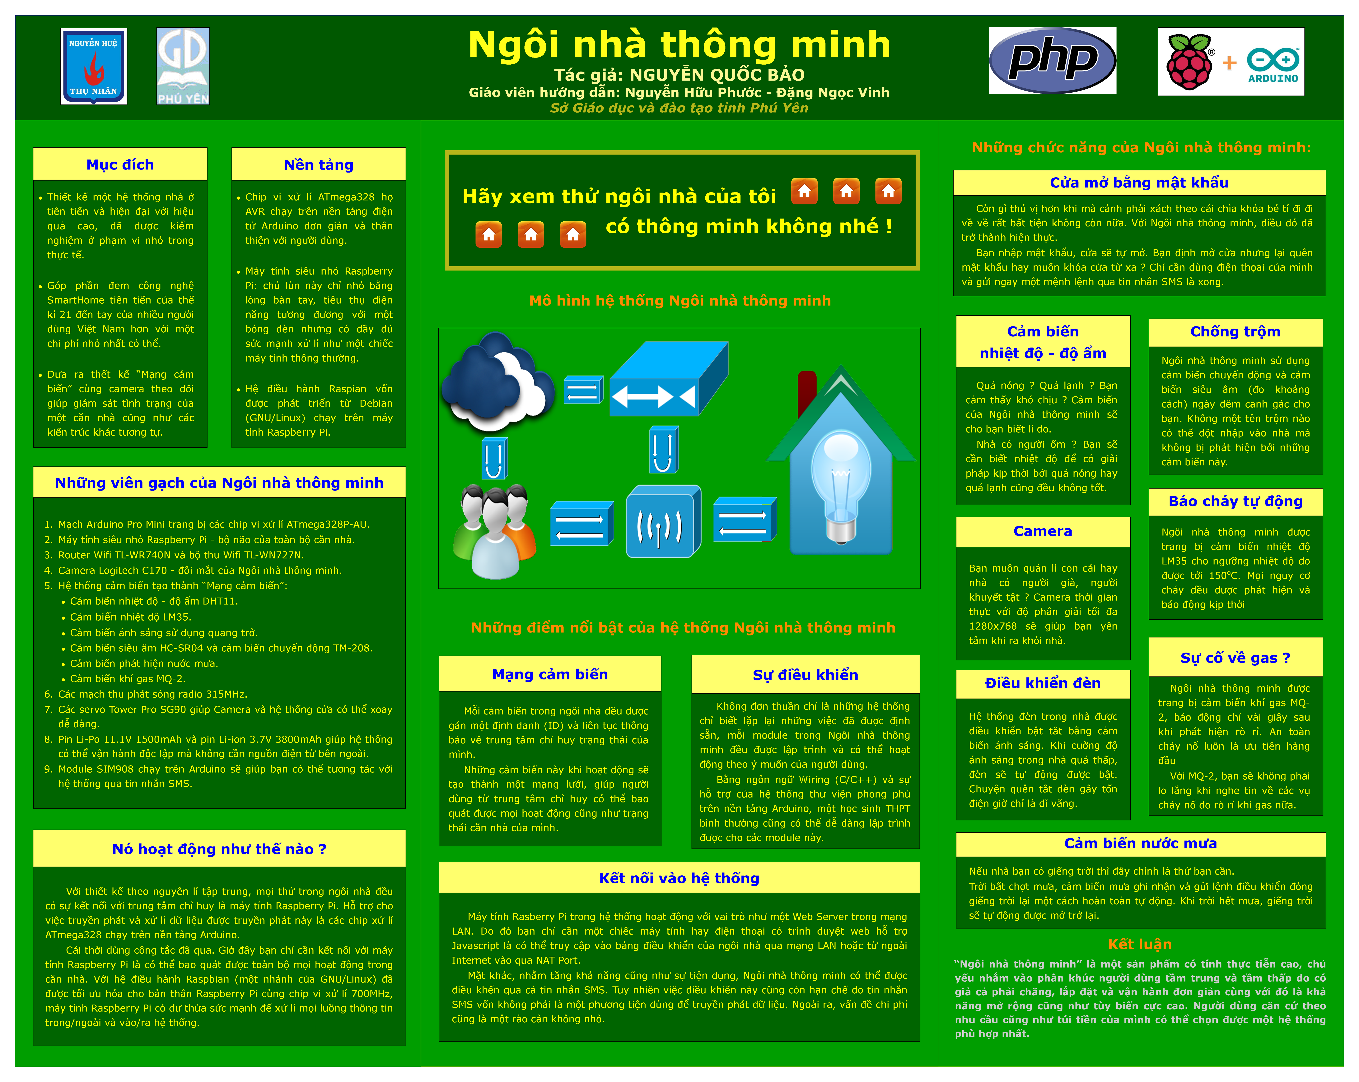
poster.png
