1412661/smarthome/Code/Web service/pictures/files/manual/3.3.2014/19.47.28.jpg

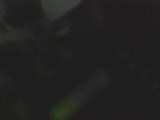
Code/Web service/pictures/files/manual/3.3.2014/19.47.28.jpg
