1412661/smarthome/Code/Web service/pictures/files/manual/3.3.2014/20.2.39.jpg

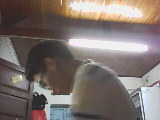
Code/Web service/pictures/files/manual/3.3.2014/20.2.39.jpg
