1412661/smarthome/Bao cao/Bia_TM.pdf

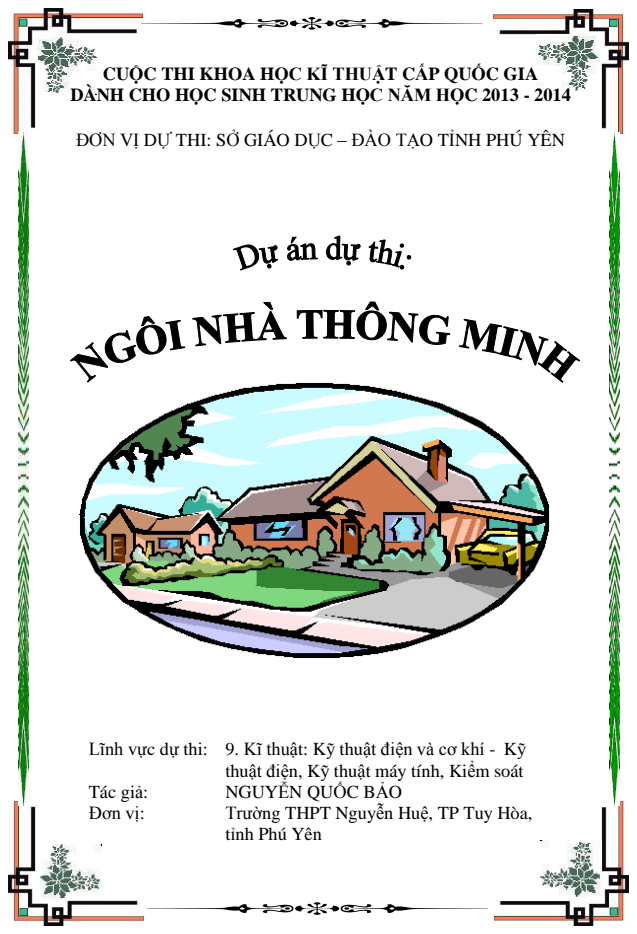
[picture p160: page 1]
Tác giả:; NGUYỄN QUỐC BẢO; Đơn vị:; Trường THPT Nguyễn Huệ, TP Tuy Hòa,

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

ĐƠN VỊ DỰ THI: SỞ GIÁO DỤC – ĐÀO TẠO TỈNH PHÚ YÊN

Lĩnh vực dự thi: 9. Kĩ thuật: Kỹ thuật điện và cơ khí - Kỹ

thuật điện, Kỹ thuật máy tính, Kiểm soát

tỉnh Phú Yên
